lytex/klangorium/kicad/logic_noise_playground.kicad_pcb

## KiCad design kicad/logic_noise_playground.kicad_pcb (2025-04-21)

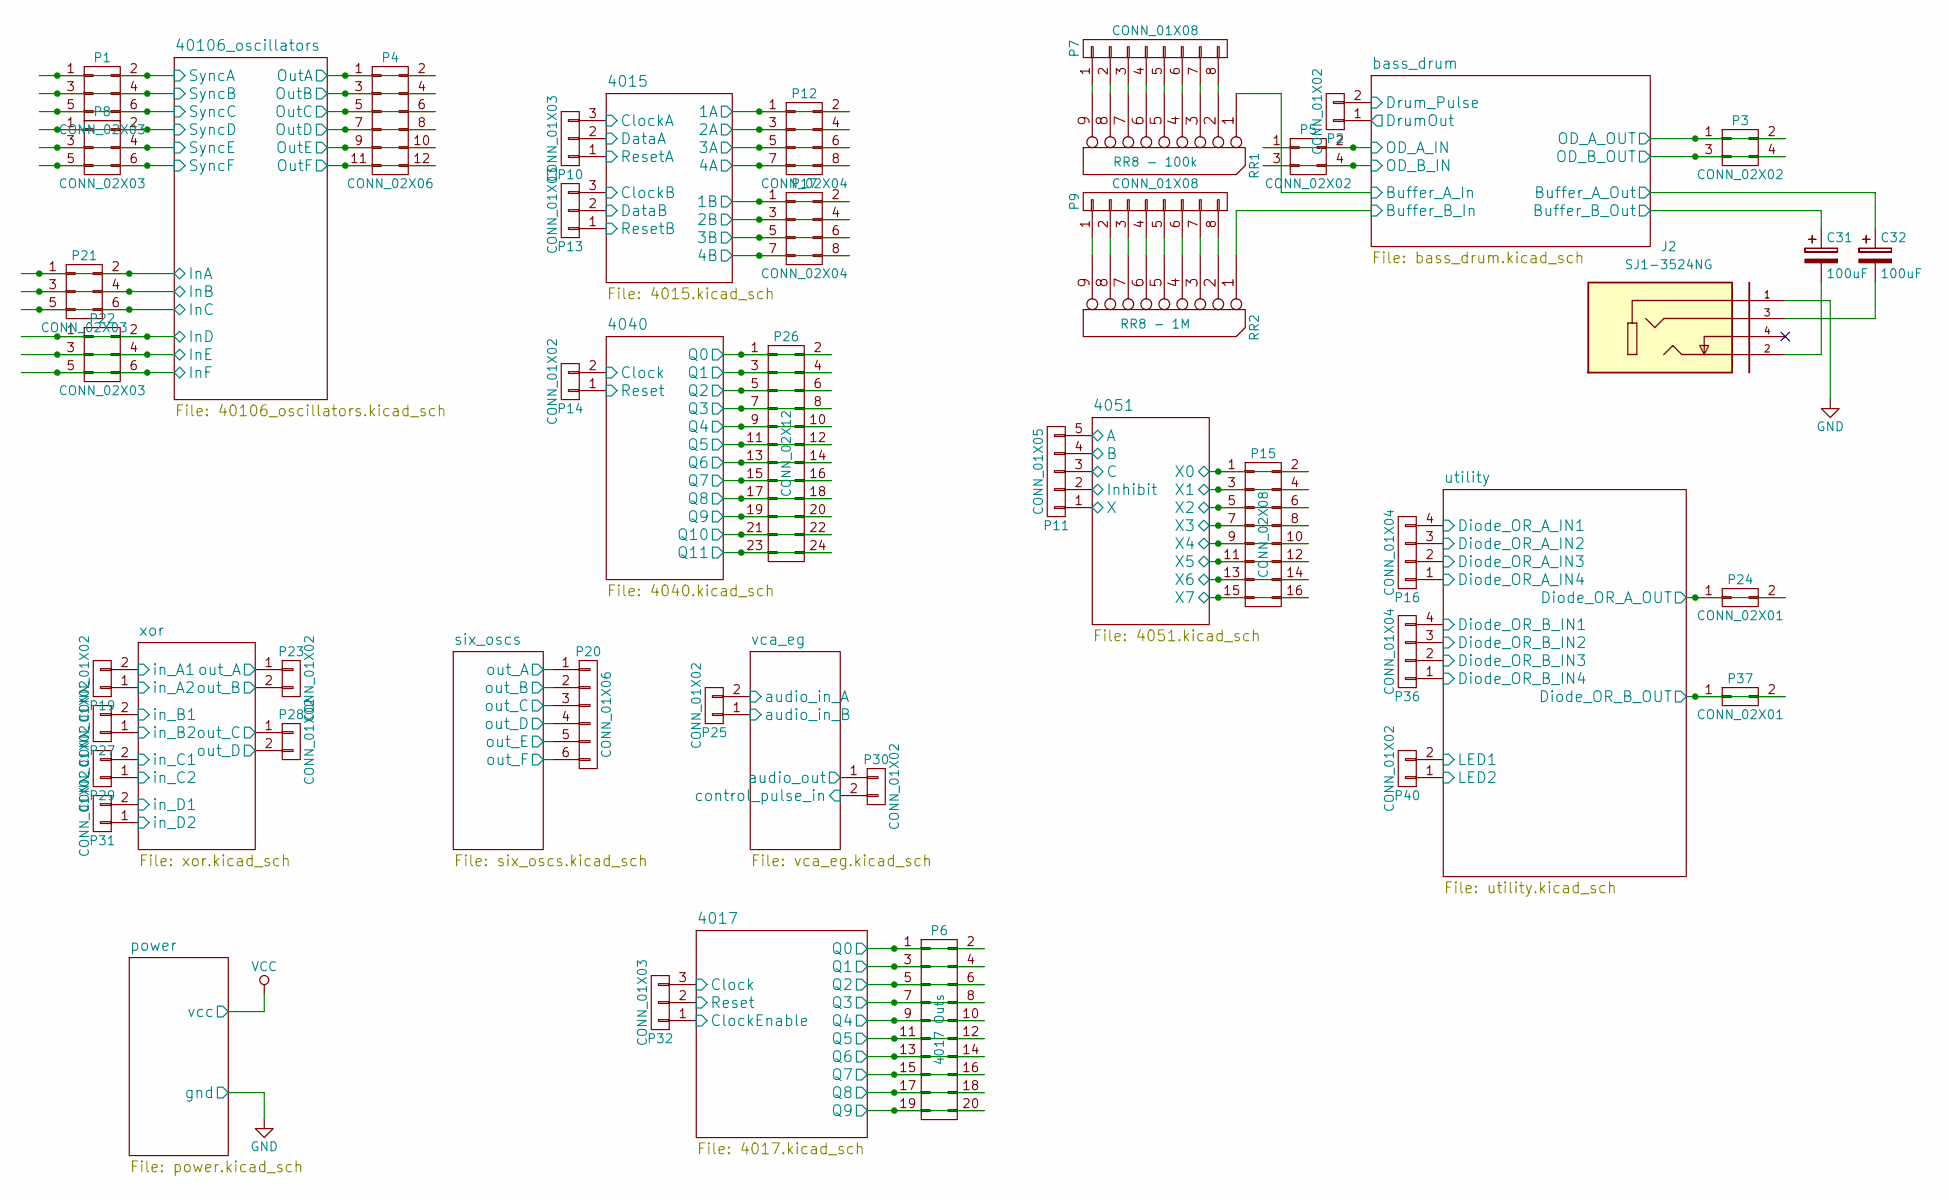
[picture p1: schematic logic_noise_playground.kicad_sch]

Parts:
C31, C32: 100uF; Elko_vert_11.2x6.3mm_RM2.5
J2: SJ1-3524NG; CUI_SJ1-3524NG
P1, P8, P21, P22: CONN_02X03; Pin_Header_Straight_2x03
P2, P14, P19, P23, P25, P27, P28, P29, P30, P31, P40: CONN_01X02; Pin_Header_Straight_1x02
P3, P5: CONN_02X02; Pin_Header_Straight_2x02
P4: CONN_02X06; Pin_Header_Straight_2x06
P6: 4017 Outs; Pin_Header_Straight_2x10
P7, P9: CONN_01X08; Pin_Header_Straight_1x08
P10, P13, P32: CONN_01X03; Pin_Header_Straight_1x03
P11: CONN_01X05; Pin_Header_Straight_1x05
P12, P17: CONN_02X04; Pin_Header_Straight_2x04
P15: CONN_02X08; Pin_Header_Straight_2x08
P16, P36: CONN_01X04; Pin_Header_Straight_1x04
P20: CONN_01X06; Pin_Header_Straight_1x06
P24, P37: CONN_02X01; Pin_Header_Straight_2x01
P26: CONN_02X12; Pin_Header_Straight_2x12
RR1: RR8 - 100k; r_pack8
RR2: RR8 - 1M; r_pack8

Connections:
/4015/1A: P12.1, P12.2; also elsewhere on the board
/4015/1B: P17.1, P17.2; also elsewhere on the board
/4015/2A: P12.3, P12.4; also elsewhere on the board
/4015/2B: P17.3, P17.4; also elsewhere on the board
/4015/3A: P12.5, P12.6; also elsewhere on the board
/4015/3B: P17.5, P17.6; also elsewhere on the board
/4015/4A: P12.7, P12.8; also elsewhere on the board
/4015/4B: P17.7, P17.8; also elsewhere on the board
/4015/ClockA: P10.3; also elsewhere on the board
/4015/ClockB: P13.3; also elsewhere on the board
/4015/DataA: P10.2; also elsewhere on the board
/4015/DataB: P13.2; also elsewhere on the board
/4015/ResetA: P10.1; also elsewhere on the board
/4015/ResetB: P13.1; also elsewhere on the board
/4017/Clock: P32.3; also elsewhere on the board
/4017/ClockEnable: P32.1; also elsewhere on the board
/4017/Q0: P6.1, P6.2; also elsewhere on the board
/4017/Q1: P6.3, P6.4; also elsewhere on the board
/4017/Q2: P6.5, P6.6; also elsewhere on the board
/4017/Q3: P6.7, P6.8; also elsewhere on the board
/4017/Q4: P6.9, P6.10; also elsewhere on the board
/4017/Q5: P6.11, P6.12; also elsewhere on the board
/4017/Q6: P6.13, P6.14; also elsewhere on the board
/4017/Q7: P6.15, P6.16; also elsewhere on the board
/4017/Q8: P6.17, P6.18; also elsewhere on the board
/4017/Q9: P6.19, P6.20; also elsewhere on the board
/4017/Reset: P32.2; also elsewhere on the board
/4040/Clock: P14.2; also elsewhere on the board
/4040/Q0: P26.1, P26.2; also elsewhere on the board
/4040/Q1: P26.3, P26.4; also elsewhere on the board
/4040/Q2: P26.5, P26.6; also elsewhere on the board
/4040/Q3: P26.7, P26.8; also elsewhere on the board
/4040/Q4: P26.9, P26.10; also elsewhere on the board
/4040/Q5: P26.11, P26.12; also elsewhere on the board
/4040/Q6: P26.13, P26.14; also elsewhere on the board
/4040/Q7: P26.15, P26.16; also elsewhere on the board
/4040/Q8: P26.17, P26.18; also elsewhere on the board
/4040/Q9: P26.19, P26.20; also elsewhere on the board
/4040/Q10: P26.21, P26.22; also elsewhere on the board
/4040/Q11: P26.23, P26.24; also elsewhere on the board
/4040/Reset: P14.1; also elsewhere on the board
/4051/A: P11.5; also elsewhere on the board
/4051/B: P11.4; also elsewhere on the board
/4051/C: P11.3; also elsewhere on the board
/4051/Inhibit: P11.2; also elsewhere on the board
/4051/X: P11.1; also elsewhere on the board
/4051/X0: P15.1, P15.2; also elsewhere on the board
/4051/X1: P15.3, P15.4; also elsewhere on the board
/4051/X2: P15.5, P15.6; also elsewhere on the board
/4051/X3: P15.7, P15.8; also elsewhere on the board
/4051/X4: P15.9, P15.10; also elsewhere on the board
/4051/X5: P15.11, P15.12; also elsewhere on the board
/4051/X6: P15.13, P15.14; also elsewhere on the board
/4051/X7: P15.15, P15.16; also elsewhere on the board
/40106_oscillators/InA: P21.1, P21.2; also elsewhere on the board
/40106_oscillators/InB: P21.3, P21.4; also elsewhere on the board
/40106_oscillators/InC: P21.5, P21.6; also elsewhere on the board
/40106_oscillators/InD: P22.1, P22.2; also elsewhere on the board
/40106_oscillators/InE: P22.3, P22.4; also elsewhere on the board
/40106_oscillators/InF: P22.5, P22.6; also elsewhere on the board
/40106_oscillators/OutA: P4.1, P4.2; also elsewhere on the board
/40106_oscillators/OutB: P4.3, P4.4; also elsewhere on the board
/40106_oscillators/OutC: P4.5, P4.6; also elsewhere on the board
/40106_oscillators/OutD: P4.7, P4.8; also elsewhere on the board
/40106_oscillators/OutE: P4.9, P4.10; also elsewhere on the board
/40106_oscillators/OutF: P4.11, P4.12; also elsewhere on the board
/40106_oscillators/SyncA: P1.1, P1.2; also elsewhere on the board
/40106_oscillators/SyncB: P1.3, P1.4; also elsewhere on the board
/40106_oscillators/SyncC: P1.5, P1.6; also elsewhere on the board
/40106_oscillators/SyncD: P8.1, P8.2; also elsewhere on the board
/40106_oscillators/SyncE: P8.3, P8.4; also elsewhere on the board
/40106_oscillators/SyncF: P8.5, P8.6; also elsewhere on the board
/bass_drum/Buffer_A_In: RR1.1 (COM); also elsewhere on the board
/bass_drum/Buffer_A_Out: C32.1; also elsewhere on the board
/bass_drum/Buffer_B_In: RR2.1 (COM); also elsewhere on the board
/bass_drum/Buffer_B_Out: C31.1; also elsewhere on the board
/bass_drum/DrumOut: P2.1; also elsewhere on the board
/bass_drum/Drum_Pulse: P2.2; also elsewhere on the board
/bass_drum/OD_A_IN: P5.1, P5.2; also elsewhere on the board
/bass_drum/OD_A_OUT: P3.1, P3.2; also elsewhere on the board
/bass_drum/OD_B_IN: P5.3, P5.4; also elsewhere on the board
/bass_drum/OD_B_OUT: P3.3, P3.4; also elsewhere on the board
/six_oscs/out_A: P20.1; also elsewhere on the board
/six_oscs/out_B: P20.2; also elsewhere on the board
/six_oscs/out_C: P20.3; also elsewhere on the board
/six_oscs/out_D: P20.4; also elsewhere on the board
/six_oscs/out_E: P20.5; also elsewhere on the board
/six_oscs/out_F: P20.6; also elsewhere on the board
/utility/Diode_OR_A_IN1: P16.4; also elsewhere on the board
/utility/Diode_OR_A_IN2: P16.3; also elsewhere on the board
/utility/Diode_OR_A_IN3: P16.2; also elsewhere on the board
/utility/Diode_OR_A_IN4: P16.1; also elsewhere on the board
/utility/Diode_OR_A_OUT: P24.1, P24.2; also elsewhere on the board
/utility/Diode_OR_B_IN1: P36.4; also elsewhere on the board
/utility/Diode_OR_B_IN2: P36.3; also elsewhere on the board
/utility/Diode_OR_B_IN3: P36.2; also elsewhere on the board
/utility/Diode_OR_B_IN4: P36.1; also elsewhere on the board
/utility/Diode_OR_B_OUT: P37.1, P37.2; also elsewhere on the board
/utility/LED1: P40.2; also elsewhere on the board
/utility/LED2: P40.1; also elsewhere on the board
/vca_eg/audio_in_A: P25.2; also elsewhere on the board
/vca_eg/audio_in_B: P25.1; also elsewhere on the board
/vca_eg/audio_out: P30.1; also elsewhere on the board
/vca_eg/control_pulse_in: P30.2; also elsewhere on the board
/xor/in_A1: P19.2; also elsewhere on the board
/xor/in_A2: P19.1; also elsewhere on the board
/xor/in_B1: P27.2; also elsewhere on the board
/xor/in_B2: P27.1; also elsewhere on the board
/xor/in_C1: P29.2; also elsewhere on the board
/xor/in_C2: P29.1; also elsewhere on the board
/xor/in_D1: P31.2; also elsewhere on the board
/xor/in_D2: P31.1; also elsewhere on the board
/xor/out_A: P23.1; also elsewhere on the board
/xor/out_B: P23.2; also elsewhere on the board
/xor/out_C: P28.1; also elsewhere on the board
/xor/out_D: P28.2; also elsewhere on the board
GND: J2.1; also elsewhere on the board
unnamed: C31.2, J2.2
unnamed: C32.2, J2.3
unnamed: P7.1, RR1.9
unnamed: P7.2, RR1.8
unnamed: P7.3, RR1.7
unnamed: P7.4, RR1.6
unnamed: P7.5, RR1.5
unnamed: P7.6, RR1.4
unnamed: P7.7, RR1.3
unnamed: P7.8, RR1.2
unnamed: P9.1, RR2.9
unnamed: P9.2, RR2.8
unnamed: P9.3, RR2.7
unnamed: P9.4, RR2.6
unnamed: P9.5, RR2.5
unnamed: P9.6, RR2.4
unnamed: P9.7, RR2.3
unnamed: P9.8, RR2.2

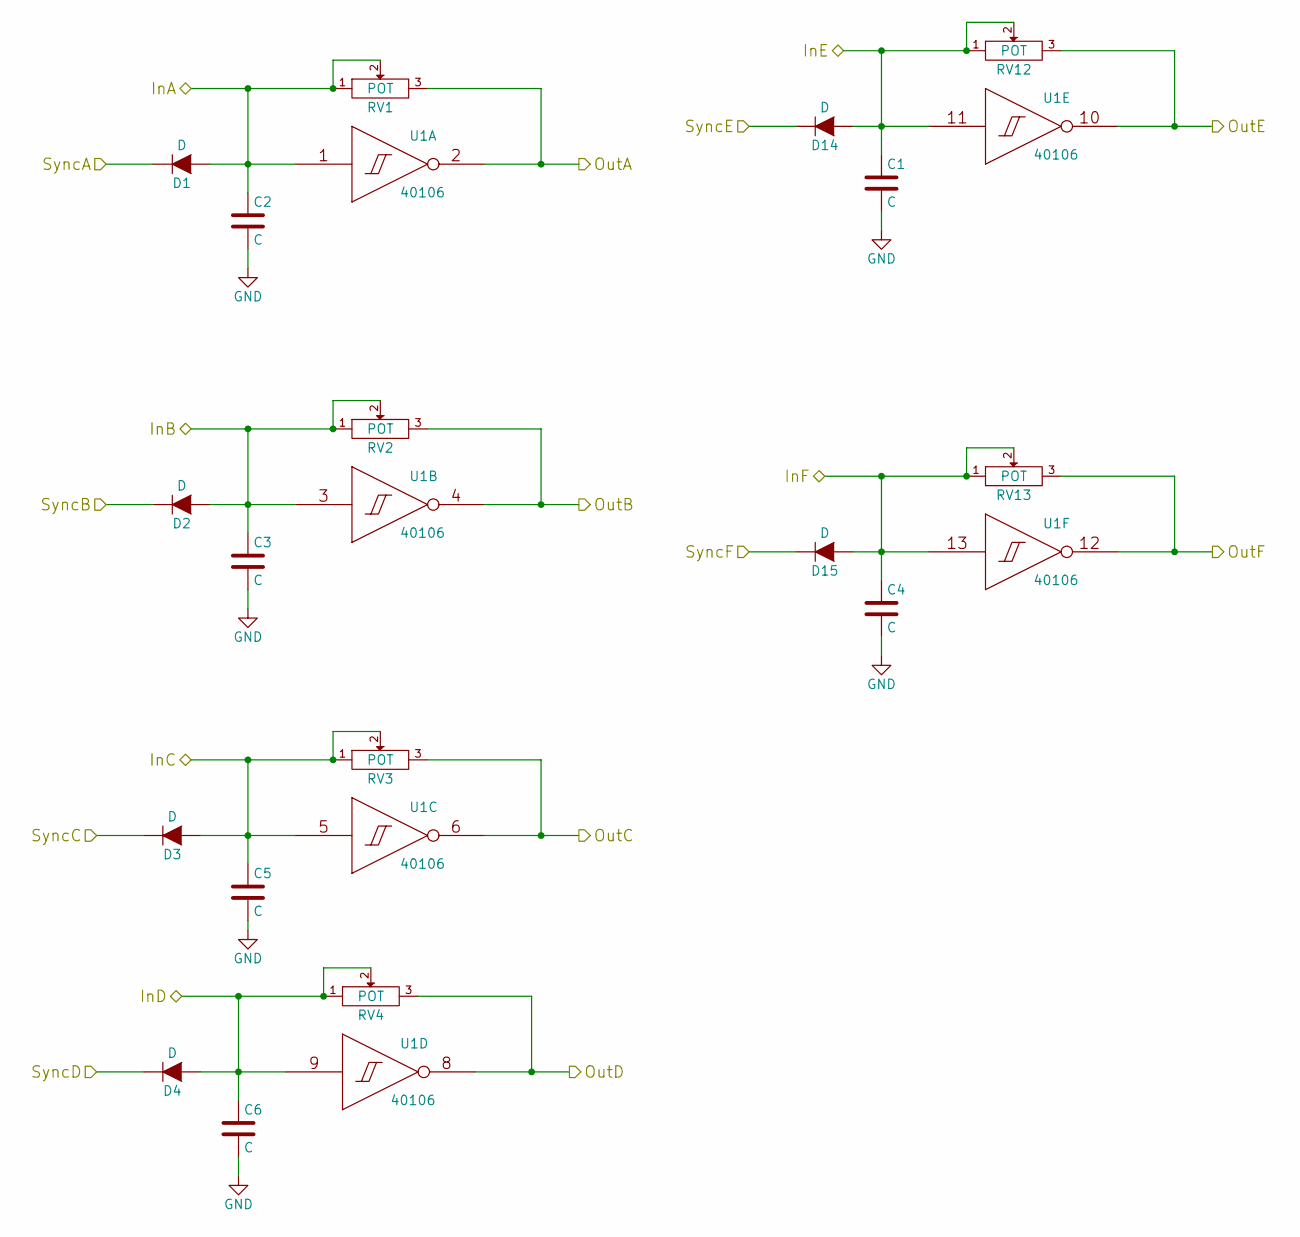
[picture p2: schematic 40106_oscillators.kicad_sch]

Parts:
C1, C2, C3, C4, C5, C6: C; cap_2+3
D1, D2, D3, D4, D14, D15: D; Diode_DO-35_SOD27_Horizontal_RM10
RV1, RV2, RV3, RV4, RV12, RV13: POT; PTV09A4025FB104
U1: 40106; DIP-14__300_ELL

Connections:
/40106_oscillators/InA: C2.1, D1.1 (A), RV1.1, RV1.2, U1.1 (In); also elsewhere on the board
/40106_oscillators/InB: C3.1, D2.1 (A), RV2.1, RV2.2, U1.3 (In); also elsewhere on the board
/40106_oscillators/InC: C5.1, D3.1 (A), RV3.1, RV3.2, U1.5 (In); also elsewhere on the board
/40106_oscillators/InD: C6.1, D4.1 (A), RV4.1, RV4.2, U1.9 (In); also elsewhere on the board
/40106_oscillators/InE: C1.1, D14.1 (A), RV12.1, RV12.2, U1.11 (In); also elsewhere on the board
/40106_oscillators/InF: C4.1, D15.1 (A), RV13.1, RV13.2, U1.13 (In); also elsewhere on the board
/40106_oscillators/OutA: RV1.3, U1.2 (Out); also elsewhere on the board
/40106_oscillators/OutB: RV2.3, U1.4 (Out); also elsewhere on the board
/40106_oscillators/OutC: RV3.3, U1.6 (Out); also elsewhere on the board
/40106_oscillators/OutD: RV4.3, U1.8 (Out); also elsewhere on the board
/40106_oscillators/OutE: RV12.3, U1.10 (Out); also elsewhere on the board
/40106_oscillators/OutF: RV13.3, U1.12 (Out); also elsewhere on the board
/40106_oscillators/SyncA: D1.2 (K); also elsewhere on the board
/40106_oscillators/SyncB: D2.2 (K); also elsewhere on the board
/40106_oscillators/SyncC: D3.2 (K); also elsewhere on the board
/40106_oscillators/SyncD: D4.2 (K); also elsewhere on the board
/40106_oscillators/SyncE: D14.2 (K); also elsewhere on the board
/40106_oscillators/SyncF: D15.2 (K); also elsewhere on the board
GND: C1.2, C2.2, C3.2, C4.2, C5.2, C6.2, U1.7 (VSS); also elsewhere on the board
VCC: U1.14 (VDD); also elsewhere on the board

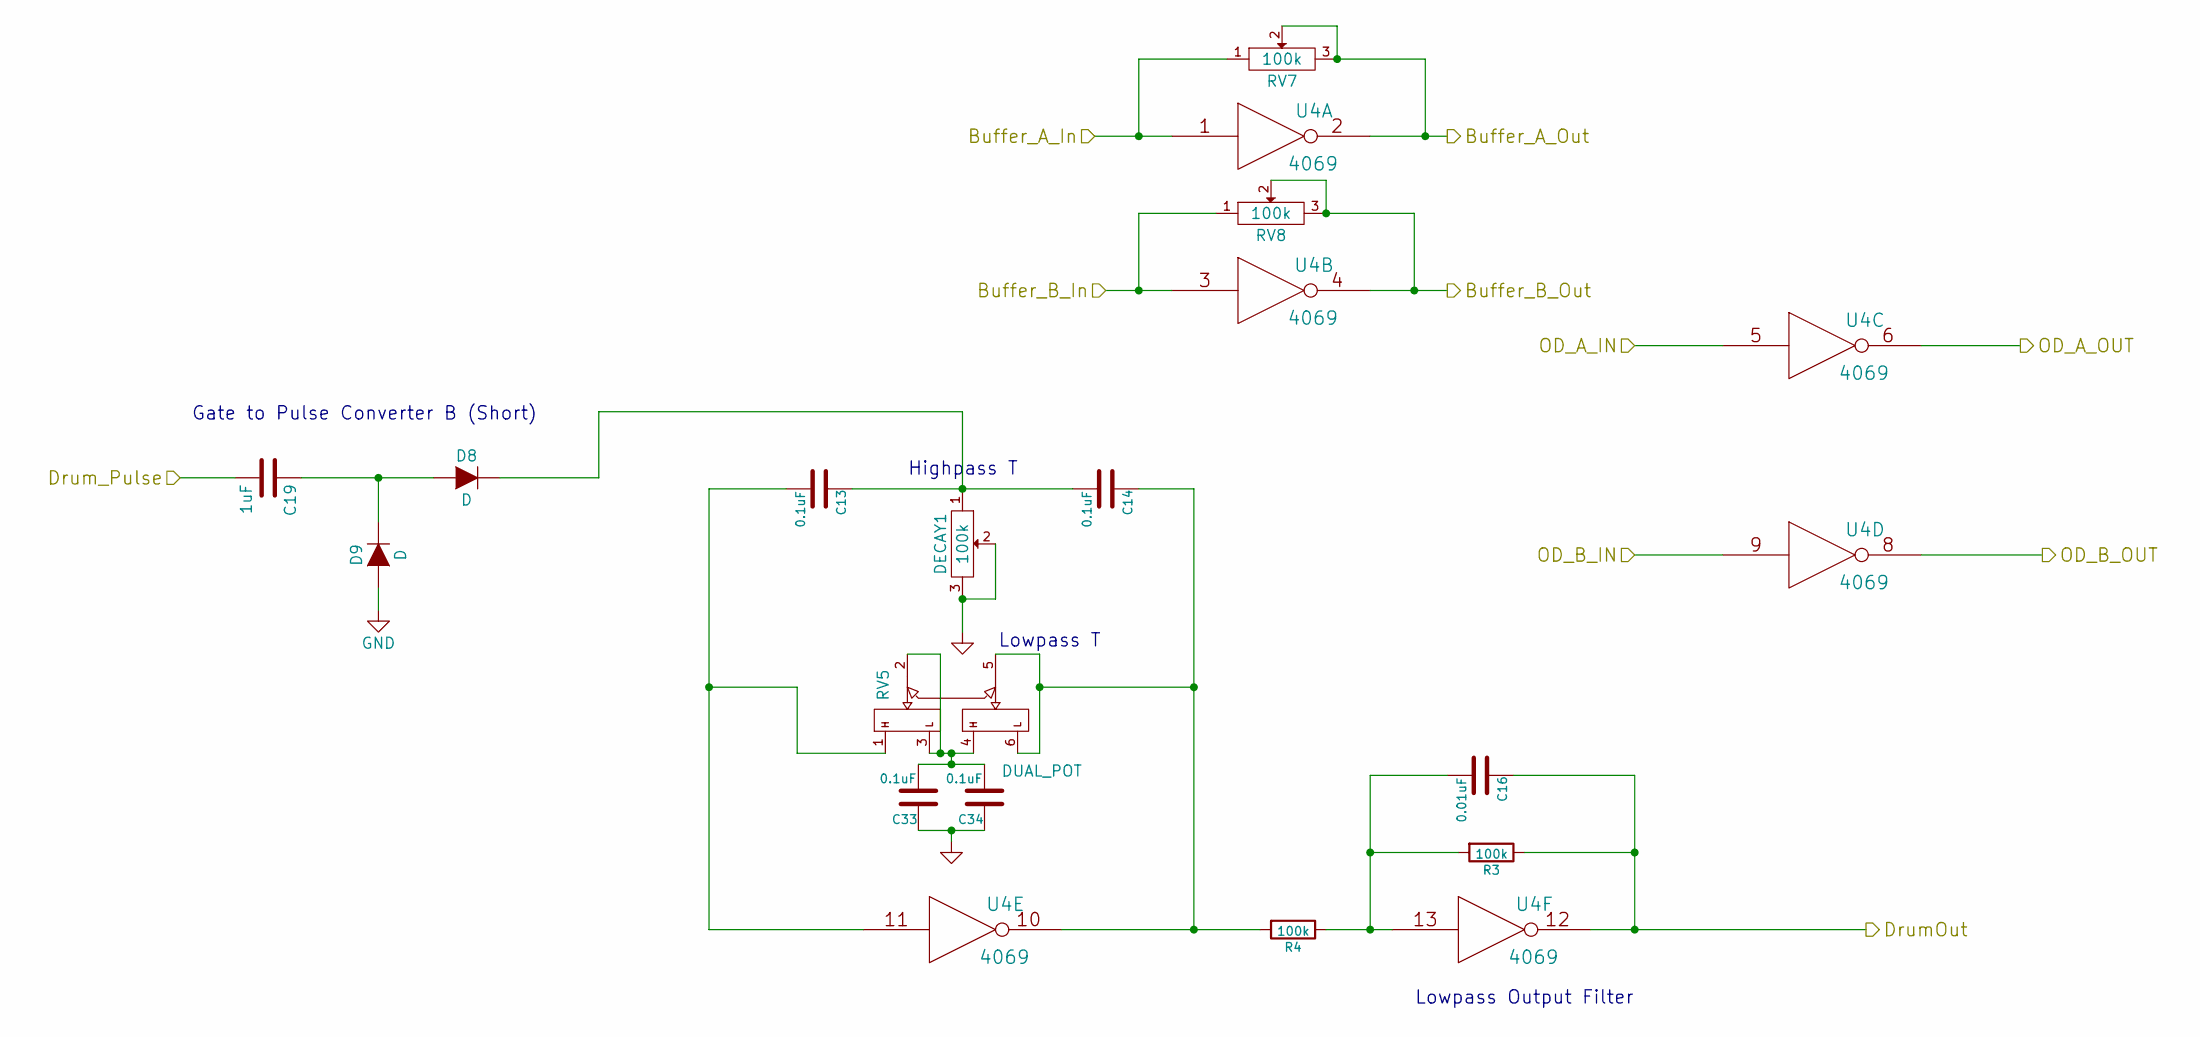
[picture p3: schematic bass_drum.kicad_sch]

Parts:
C13, C14, C33, C34: 0.1uF; C1
C16: 0.01uF; C1
C19: 1uF; C1
D8, D9: D; Diode_DO-35_SOD27_Horizontal_RM10
DECAY1: 100k; PTV09A4025FB104
R3, R4: 100k; Resistor_Horizontal_RM10mm
RV5: DUAL_POT; Potentiometer_Alps_RK163_Dual_Horizontal
RV7, RV8: 100k; PTV09A4025FB104
U4: 4069; DIP-14__300_ELL

Connections:
/bass_drum/Buffer_A_In: RV7.1, U4.1; also elsewhere on the board
/bass_drum/Buffer_A_Out: RV7.2, RV7.3, U4.2; also elsewhere on the board
/bass_drum/Buffer_B_In: RV8.1, U4.3; also elsewhere on the board
/bass_drum/Buffer_B_Out: RV8.2, RV8.3, U4.4; also elsewhere on the board
/bass_drum/DrumOut: C16.1, R3.1, U4.12; also elsewhere on the board
/bass_drum/Drum_Pulse: C19.2; also elsewhere on the board
/bass_drum/OD_A_IN: U4.5; also elsewhere on the board
/bass_drum/OD_A_OUT: U4.6; also elsewhere on the board
/bass_drum/OD_B_IN: U4.9; also elsewhere on the board
/bass_drum/OD_B_OUT: U4.8; also elsewhere on the board
GND: C33.1, C34.1, D9.1 (A), DECAY1.2, DECAY1.3, U4.7 (VSS); also elsewhere on the board
unnamed: C13.2, RV5.1, U4.11
unnamed: C14.1, R4.2, RV5.5, RV5.6, U4.10
unnamed: C16.2, R3.2, R4.1, U4.13
unnamed: C33.2, C34.2, RV5.2, RV5.3, RV5.4
unnamed: C19.1, D8.1 (A), D9.2 (K)
unnamed: C13.1, C14.2, D8.2 (K), DECAY1.1
VCC: U4.14 (VDD); also elsewhere on the board

Notes on the sheet:
Highpass T
Lowpass Output Filter
Gate to Pulse Converter B (Short)
Lowpass T

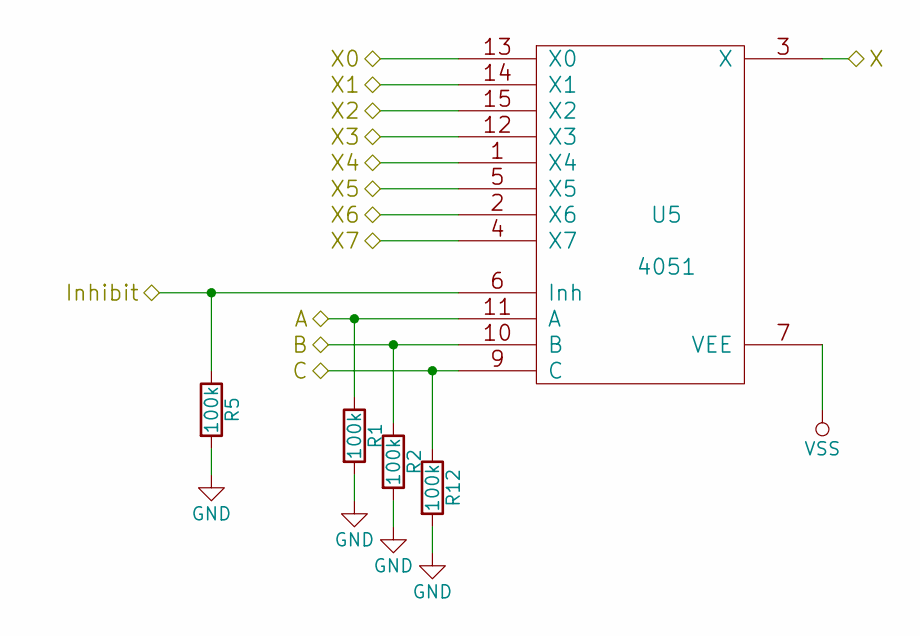
[picture p4: schematic 4051.kicad_sch]

Parts:
R1, R2, R5, R12: 100k; Resistor_Horizontal_RM10mm
U5: 4051; DIP-16__300_ELL

Connections:
/4051/A: R1.1, U5.11 (A); also elsewhere on the board
/4051/B: R2.1, U5.10 (B); also elsewhere on the board
/4051/C: R12.1, U5.9 (C); also elsewhere on the board
/4051/Inhibit: R5.1, U5.6 (Inh); also elsewhere on the board
/4051/X: U5.3 (X); also elsewhere on the board
/4051/X0: U5.13 (X0); also elsewhere on the board
/4051/X1: U5.14 (X1); also elsewhere on the board
/4051/X2: U5.15 (X2); also elsewhere on the board
/4051/X3: U5.12 (X3); also elsewhere on the board
/4051/X4: U5.1 (X4); also elsewhere on the board
/4051/X5: U5.5 (X5); also elsewhere on the board
/4051/X6: U5.2 (X6); also elsewhere on the board
/4051/X7: U5.4 (X7); also elsewhere on the board
GND: R1.2, R2.2, R5.2, R12.2, U5.7 (VEE), U5.8 (VSS); also elsewhere on the board
VCC: U5.16 (VDD); also elsewhere on the board

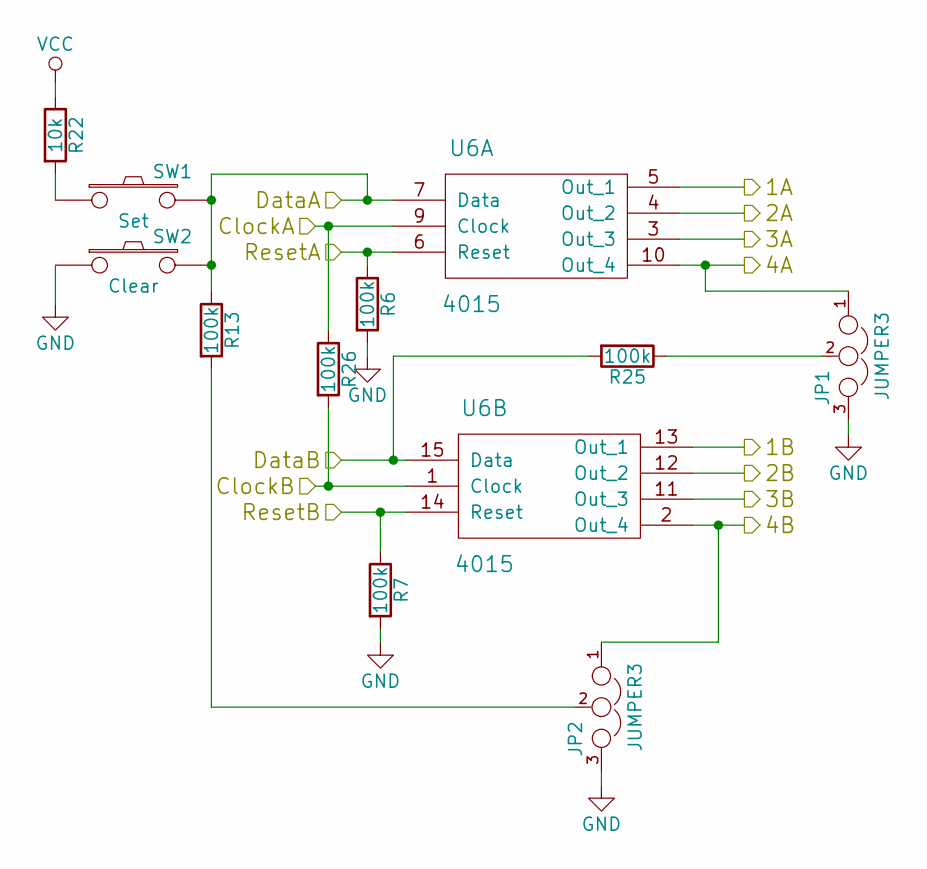
[picture p5: schematic 4015.kicad_sch]

Parts:
JP1, JP2: JUMPER3; Socket_Strip_Straight_1x03
R6, R7, R13, R25, R26: 100k; Resistor_Horizontal_RM10mm
R22: 10k; Resistor_Horizontal_RM10mm
SW1: Set; SW_PUSH_SMALL
SW2: Clear; SW_PUSH_SMALL
U6: 4015; DIP-16__300_ELL

Connections:
/4015/1A: U6.5 (Out_1); also elsewhere on the board
/4015/1B: U6.13 (Out_1); also elsewhere on the board
/4015/2A: U6.4 (Out_2); also elsewhere on the board
/4015/2B: U6.12 (Out_2); also elsewhere on the board
/4015/3A: U6.3 (Out_3); also elsewhere on the board
/4015/3B: U6.11 (Out_3); also elsewhere on the board
/4015/4A: JP1.1, U6.10 (Out_4); also elsewhere on the board
/4015/4B: JP2.1, U6.2 (Out_4); also elsewhere on the board
/4015/ClockA: R26.1, U6.9 (Clock); also elsewhere on the board
/4015/ClockB: R26.2, U6.1 (Clock); also elsewhere on the board
/4015/DataA: R13.1, SW1.2, SW2.2, U6.7 (Data); also elsewhere on the board
/4015/DataB: R25.2, U6.15 (Data); also elsewhere on the board
/4015/ResetA: R6.1, U6.6 (Reset); also elsewhere on the board
/4015/ResetB: R7.1, U6.14 (Reset); also elsewhere on the board
GND: JP1.3, JP2.3, R6.2, R7.2, SW2.1, U6.8 (VSS); also elsewhere on the board
unnamed: JP1.2, R25.1
unnamed: JP2.2, R13.2
unnamed: R22.2, SW1.1
VCC: R22.1, U6.16 (VDD); also elsewhere on the board

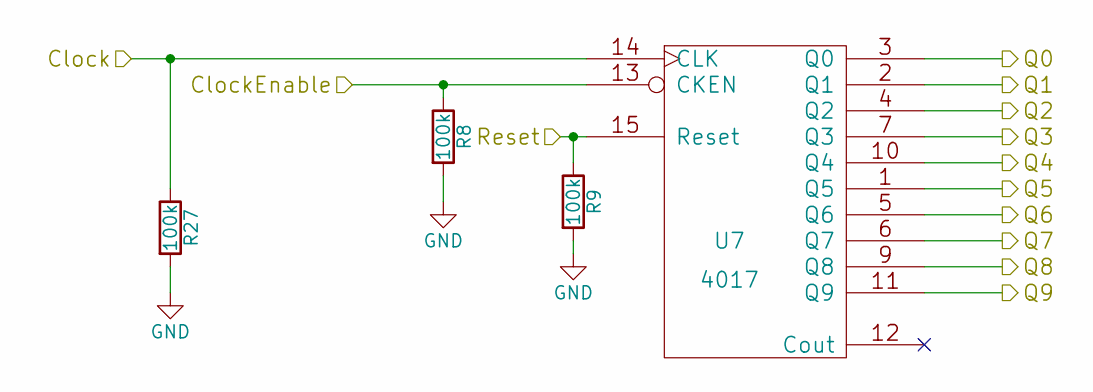
[picture p6: schematic 4017.kicad_sch]

Parts:
R8, R9, R27: 100k; Resistor_Horizontal_RM10mm
U7: 4017; DIP-16__300_ELL

Connections:
/4017/Clock: R27.1, U7.14 (CLK); also elsewhere on the board
/4017/ClockEnable: R8.1, U7.13 (CKEN); also elsewhere on the board
/4017/Q0: U7.3 (Q0); also elsewhere on the board
/4017/Q1: U7.2 (Q1); also elsewhere on the board
/4017/Q2: U7.4 (Q2); also elsewhere on the board
/4017/Q3: U7.7 (Q3); also elsewhere on the board
/4017/Q4: U7.10 (Q4); also elsewhere on the board
/4017/Q5: U7.1 (Q5); also elsewhere on the board
/4017/Q6: U7.5 (Q6); also elsewhere on the board
/4017/Q7: U7.6 (Q7); also elsewhere on the board
/4017/Q8: U7.9 (Q8); also elsewhere on the board
/4017/Q9: U7.11 (Q9); also elsewhere on the board
/4017/Reset: R9.1, U7.15 (Reset); also elsewhere on the board
GND: R8.2, R9.2, R27.2, U7.8 (VSS); also elsewhere on the board
VCC: U7.16 (VDD); also elsewhere on the board

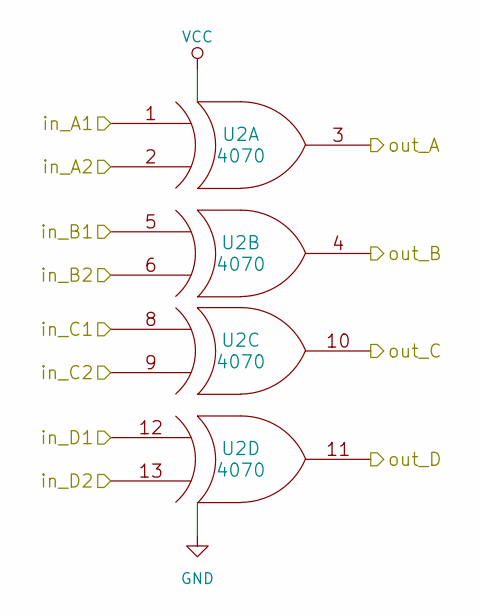
[picture p7: schematic xor.kicad_sch]

Parts:
U2: 4070; DIP-14__300_ELL

Connections:
/xor/in_A1: U2.1; also elsewhere on the board
/xor/in_A2: U2.2; also elsewhere on the board
/xor/in_B1: U2.5; also elsewhere on the board
/xor/in_B2: U2.6; also elsewhere on the board
/xor/in_C1: U2.8; also elsewhere on the board
/xor/in_C2: U2.9; also elsewhere on the board
/xor/in_D1: U2.12; also elsewhere on the board
/xor/in_D2: U2.13; also elsewhere on the board
/xor/out_A: U2.3; also elsewhere on the board
/xor/out_B: U2.4; also elsewhere on the board
/xor/out_C: U2.10; also elsewhere on the board
/xor/out_D: U2.11; also elsewhere on the board
GND: U2.7 (VSS); also elsewhere on the board
VCC: U2.14 (VDD); also elsewhere on the board

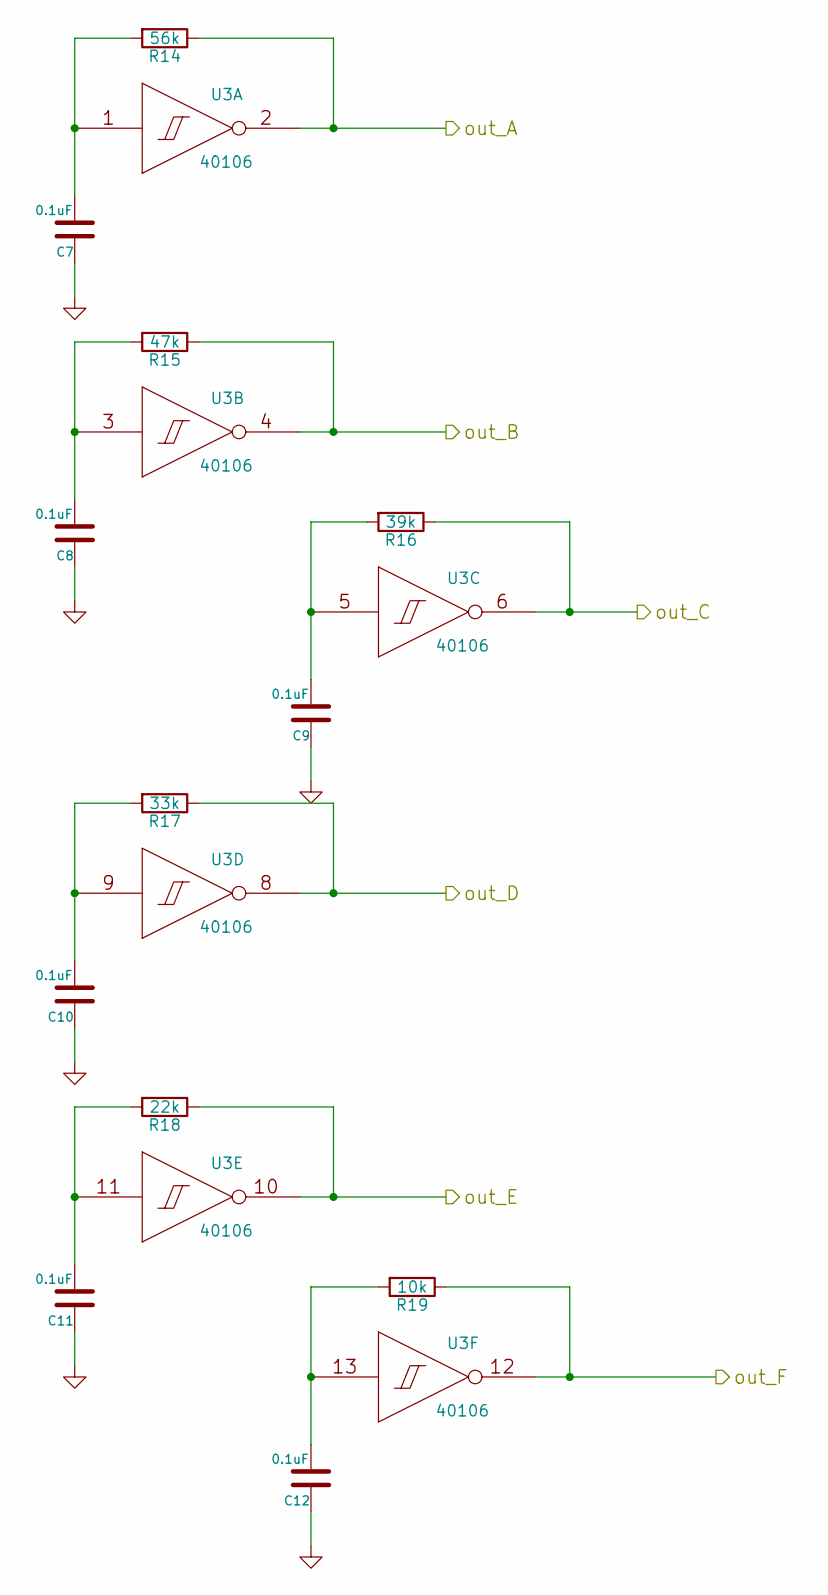
[picture p8: schematic six_oscs.kicad_sch]

Parts:
C7, C8, C9, C10, C11, C12: 0.1uF; C1
R14: 56k; Resistor_Horizontal_RM10mm
R15: 47k; Resistor_Horizontal_RM10mm
R16: 39k; Resistor_Horizontal_RM10mm
R17: 33k; Resistor_Horizontal_RM10mm
R18: 22k; Resistor_Horizontal_RM10mm
R19: 10k; Resistor_Horizontal_RM10mm
U3: 40106; DIP-14__300_ELL

Connections:
/six_oscs/out_A: R14.1, U3.2 (Out); also elsewhere on the board
/six_oscs/out_B: R15.1, U3.4 (Out); also elsewhere on the board
/six_oscs/out_C: R16.1, U3.6 (Out); also elsewhere on the board
/six_oscs/out_D: R17.1, U3.8 (Out); also elsewhere on the board
/six_oscs/out_E: R18.1, U3.10 (Out); also elsewhere on the board
/six_oscs/out_F: R19.1, U3.12 (Out); also elsewhere on the board
GND: C7.1, C8.1, C9.1, C10.1, C11.1, C12.1, U3.7 (VSS); also elsewhere on the board
unnamed: C7.2, R14.2, U3.1 (In)
unnamed: C8.2, R15.2, U3.3 (In)
unnamed: C9.2, R16.2, U3.5 (In)
unnamed: C10.2, R17.2, U3.9 (In)
unnamed: C11.2, R18.2, U3.11 (In)
unnamed: C12.2, R19.2, U3.13 (In)
VCC: U3.14 (VDD); also elsewhere on the board

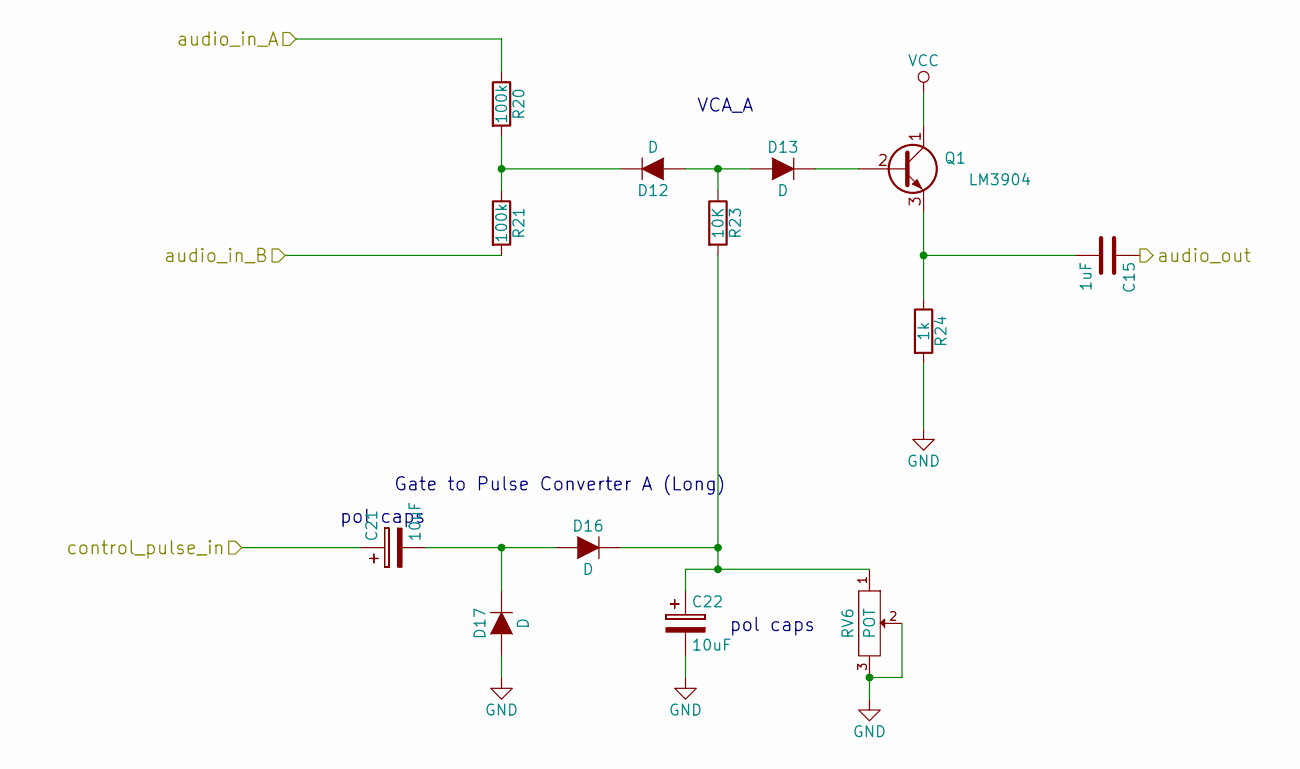
[picture p9: schematic vca_eg.kicad_sch]

Parts:
C15: 1uF; C1
C21, C22: 10uF; Elko_vert_11.2x6.3mm_RM2.5
D12, D13, D16, D17: D; Diode_DO-35_SOD27_Horizontal_RM10
Q1: LM3904; TO92
R20, R21: 100k; Resistor_Horizontal_RM10mm
R23: 10K; Resistor_Horizontal_RM10mm
R24: 1k; Resistor_Horizontal_RM10mm
RV6: POT; PTV09A4025FB104

Connections:
/vca_eg/audio_in_A: R20.1; also elsewhere on the board
/vca_eg/audio_in_B: R21.2; also elsewhere on the board
/vca_eg/audio_out: C15.1; also elsewhere on the board
/vca_eg/control_pulse_in: C21.1; also elsewhere on the board
GND: C22.2, D17.1 (A), R24.2, RV6.2, RV6.3; also elsewhere on the board
unnamed: D12.1 (A), D13.1 (A), R23.1
unnamed: D12.2 (K), R20.2, R21.1
unnamed: D13.2 (K), Q1.2 (B)
unnamed: C21.2, D16.1 (A), D17.2 (K)
unnamed: C22.1, D16.2 (K), R23.2, RV6.1
unnamed: C15.2, Q1.3 (E), R24.1
VCC: Q1.1 (C); also elsewhere on the board

Notes on the sheet:
pol caps
VCA_A
Gate to Pulse Converter A (Long)

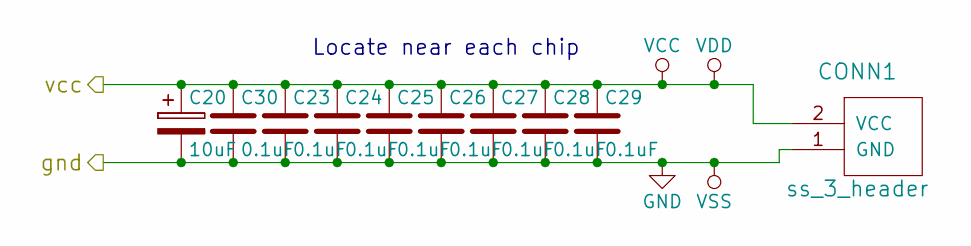
[picture p10: schematic power.kicad_sch]

Parts:
C20: 10uF; Elko_vert_11.2x6.3mm_RM2.5
C23, C24, C25, C26, C27, C28, C29, C30: 0.1uF; C1
CONN1: ss_3_header; connector_ss_3pin

Connections:
GND: C20.2, C23.2, C24.2, C25.2, C26.2, C27.2, C28.2, C29.2, C30.2, CONN1.1 (GND); also elsewhere on the board
VCC: C20.1, C23.1, C24.1, C25.1, C26.1, C27.1, C28.1, C29.1, C30.1, CONN1.2 (VCC); also elsewhere on the board

Notes on the sheet:
Locate near each chip
