lytex/klangorium/kicad/logic_noise_playground.kicad_pcb

## KiCad design kicad/logic_noise_playground.kicad_pcb (continued)

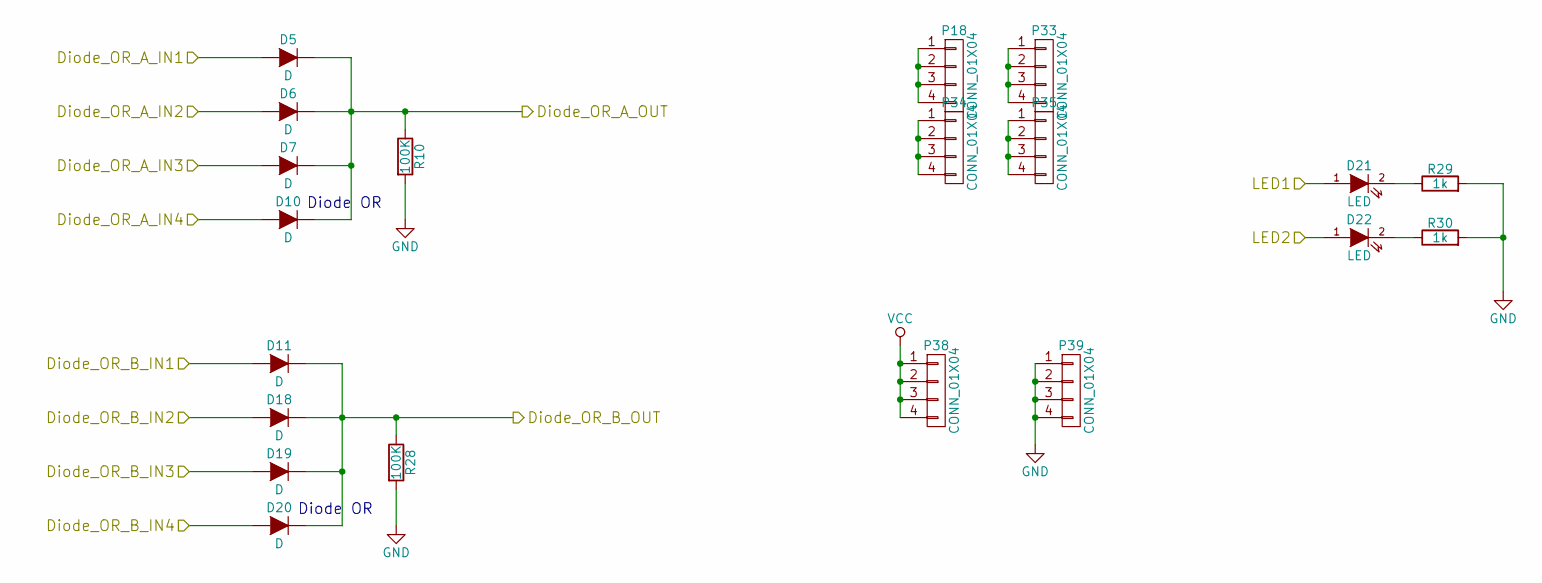
[picture p11: schematic utility.kicad_sch]

Parts:
D5, D6, D7, D10, D11, D18, D19, D20: D; Diode_DO-35_SOD27_Horizontal_RM10
D21, D22: LED; LED-5MM
P18, P33, P34, P35, P38, P39: CONN_01X04; Pin_Header_Straight_1x04
R10, R28: 100K; Resistor_Horizontal_RM10mm
R29, R30: 1k; Resistor_Horizontal_RM10mm

Connections:
/utility/Diode_OR_A_IN1: D5.1 (A); also elsewhere on the board
/utility/Diode_OR_A_IN2: D6.1 (A); also elsewhere on the board
/utility/Diode_OR_A_IN3: D7.1 (A); also elsewhere on the board
/utility/Diode_OR_A_IN4: D10.1 (A); also elsewhere on the board
/utility/Diode_OR_A_OUT: D5.2 (K), D6.2 (K), D7.2 (K), D10.2 (K), R10.1; also elsewhere on the board
/utility/Diode_OR_B_IN1: D11.1 (A); also elsewhere on the board
/utility/Diode_OR_B_IN2: D18.1 (A); also elsewhere on the board
/utility/Diode_OR_B_IN3: D19.1 (A); also elsewhere on the board
/utility/Diode_OR_B_IN4: D20.1 (A); also elsewhere on the board
/utility/Diode_OR_B_OUT: D11.2 (K), D18.2 (K), D19.2 (K), D20.2 (K), R28.1; also elsewhere on the board
/utility/LED1: D21.1 (A); also elsewhere on the board
/utility/LED2: D22.1 (A); also elsewhere on the board
GND: P39.1, P39.2, P39.3, P39.4, R10.2, R28.2, R29.2, R30.2; also elsewhere on the board
unnamed: D21.2 (K), R29.1
unnamed: D22.2 (K), R30.1
unnamed: P18.1, P18.2, P18.3, P18.4
unnamed: P33.1, P33.2, P33.3, P33.4
unnamed: P34.1, P34.2, P34.3, P34.4
unnamed: P35.1, P35.2, P35.3, P35.4
VCC: P38.1, P38.2, P38.3, P38.4; also elsewhere on the board

Notes on the sheet:
Diode OR

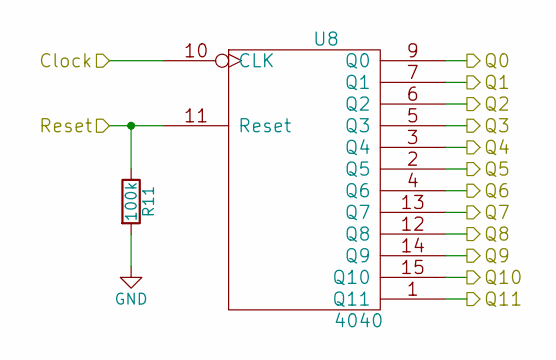
[picture p12: schematic 4040.kicad_sch]

Parts:
R11: 100k; Resistor_Horizontal_RM10mm
U8: 4040; DIP-16__300_ELL

Connections:
/4040/Clock: U8.10 (CLK); also elsewhere on the board
/4040/Q0: U8.9 (Q0); also elsewhere on the board
/4040/Q1: U8.7 (Q1); also elsewhere on the board
/4040/Q2: U8.6 (Q2); also elsewhere on the board
/4040/Q3: U8.5 (Q3); also elsewhere on the board
/4040/Q4: U8.3 (Q4); also elsewhere on the board
/4040/Q5: U8.2 (Q5); also elsewhere on the board
/4040/Q6: U8.4 (Q6); also elsewhere on the board
/4040/Q7: U8.13 (Q7); also elsewhere on the board
/4040/Q8: U8.12 (Q8); also elsewhere on the board
/4040/Q9: U8.14 (Q9); also elsewhere on the board
/4040/Q10: U8.15 (Q10); also elsewhere on the board
/4040/Q11: U8.1 (Q11); also elsewhere on the board
/4040/Reset: R11.1, U8.11 (Reset); also elsewhere on the board
GND: R11.2, U8.8 (VSS); also elsewhere on the board
VCC: U8.16 (VDD); also elsewhere on the board

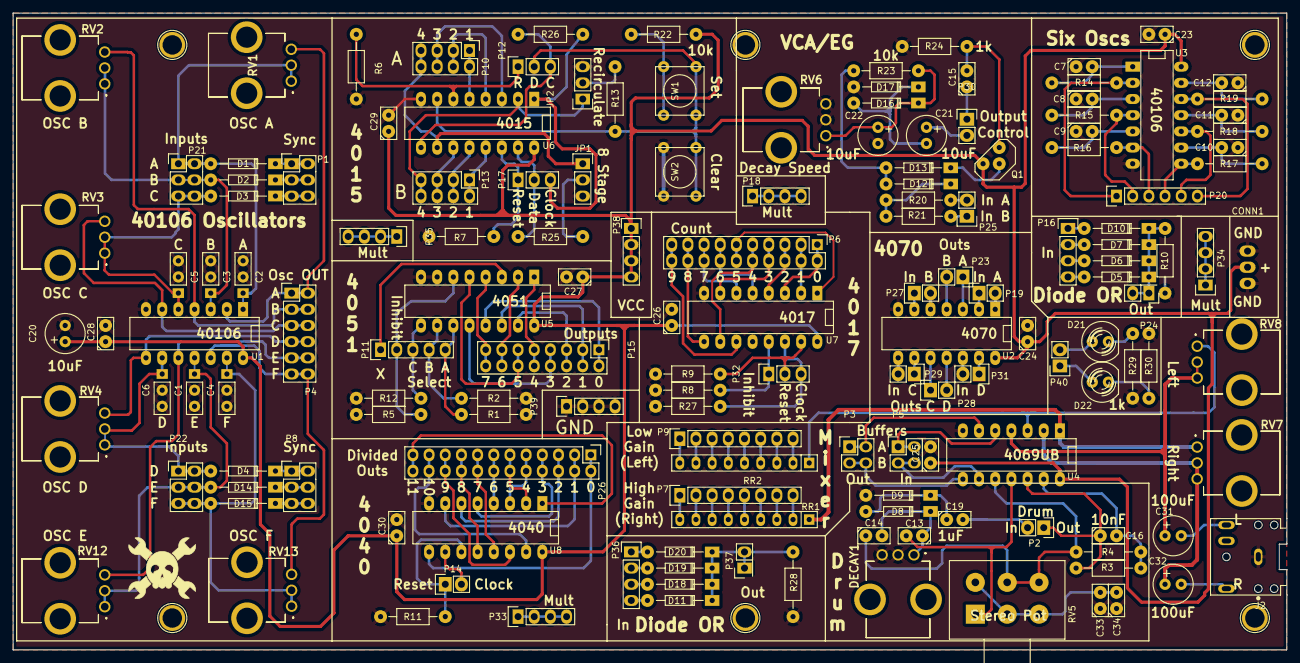
[picture p13: board logic_noise_playground.kicad_pcb from above]

Board: 2 copper layers, 200.0 x 100.0 mm, 152 parts (0 on the bottom side), 163 nets.
