lytex/klangorium/(commit log)

2024-02-27 Saved from KiCad 8.0 and parts list information
    [logic_noise_playground.kicad_pcb]
2024-03-22 update all project to KiCad8
    [40106_oscillators.kicad_sch, 4015.kicad_sch, 4017.kicad_sch, 4040.kicad_sch, 4051.kicad_sch, bass_drum.kicad_sch, logic_noise_playground.kicad_pcb, logic_noise_playground.kicad_sch]
2024-03-22 erase previous files
    [40106_oscillators.sch, 4015.sch, 4017.sch, 4040.sch, 4051.sch, 4069_mixer.sch, bass_drum.sch, cymbals.sch]
2024-03-22 fix silkscreen labels
    [logic_noise_playground.kicad_pcb]
2024-03-22 fix vcc and grounding
    [logic_noise_playground.kicad_pcb]
2024-03-22 update part numbers
    [40106_oscillators.kicad_sch, 4015.kicad_sch, 4017.kicad_sch, 4040.kicad_sch, 4051.kicad_sch, bass_drum.kicad_sch, logic_noise_playground.kicad_pcb, logic_noise_playground.kicad_sch]
2024-03-22 update traces
    [logic_noise_playground.kicad_pcb]
2024-03-27 change pots
    [40106_oscillators.kicad_sch, bass_drum.kicad_sch, logic_noise_playground.kicad_pcb, vca_eg.kicad_sch, xor.kicad_sch]
2024-03-27 update resistors values
    [4015.kicad_sch, 4017.kicad_sch, 4040.kicad_sch, 4051.kicad_sch, bass_drum.kicad_sch, logic_noise_playground.kicad_pcb, six_oscs.kicad_sch, utility.kicad_sch]
2024-03-28 update connectors
    [logic_noise_playground.kicad_sch]
2024-04-01 update caps
    [six_oscs.kicad_sch, utility.kicad_sch]
2024-04-01 update stereo TRSS connector
    [40106_oscillators.kicad_sch, 4015.kicad_sch, 4017.kicad_sch, 4040.kicad_sch, 4051.kicad_sch, bass_drum.kicad_sch, logic_noise_playground.kicad_pcb, logic_noise_playground.kicad_sch]
2024-06-03 update BOM
    [logicNoise_BOM.csv, logic_noise_playground.kicad_pcb, logic_noise_playground.kicad_sch]
2024-08-13 update reference number output
    [logic_noise_playground-B_Cu.gbl, logic_noise_playground-B_Cu.gbr, logic_noise_playground-B_Fab.gbr, logic_noise_playground-B_Mask.gbr, logic_noise_playground-B_Mask.gbs, logic_noise_playground-B_SilkS.gbr, logic_noise_playground-B_Silkscreen.gbo, logic_noise_playground-Edge_Cuts.gm1]
2024-08-22 update gerbers
    [logic_noise_playground-B_Cu.gbl, logic_noise_playground-B_Fab.gbr, logic_noise_playground-B_Mask.gbs, logic_noise_playground-B_Silkscreen.gbo, logic_noise_playground-Edge_Cuts.gm1, logic_noise_playground-F_Cu.gtl, logic_noise_playground-F_Fab.gbr, logic_noise_playground-F_Mask.gts]
2025-04-21 update to kicad 9, add some comments and circuit changes
    [40106_oscillators.kicad_sch, 4015.kicad_sch, 4017.kicad_sch, 4040.kicad_sch, 4051.kicad_sch, bass_drum.kicad_sch, logic_noise_playground.kicad_pcb, logic_noise_playground.kicad_sch]
